Caiottk/Oficina2/(list of files, cad)

Other CAD files:
Data/ImageToStl.com_data9.ply
Data/ImageToStl.com_data12.ply
Data/ImageToStl.com_data13.ply
