Caiottk/Oficina2/PE.pdf

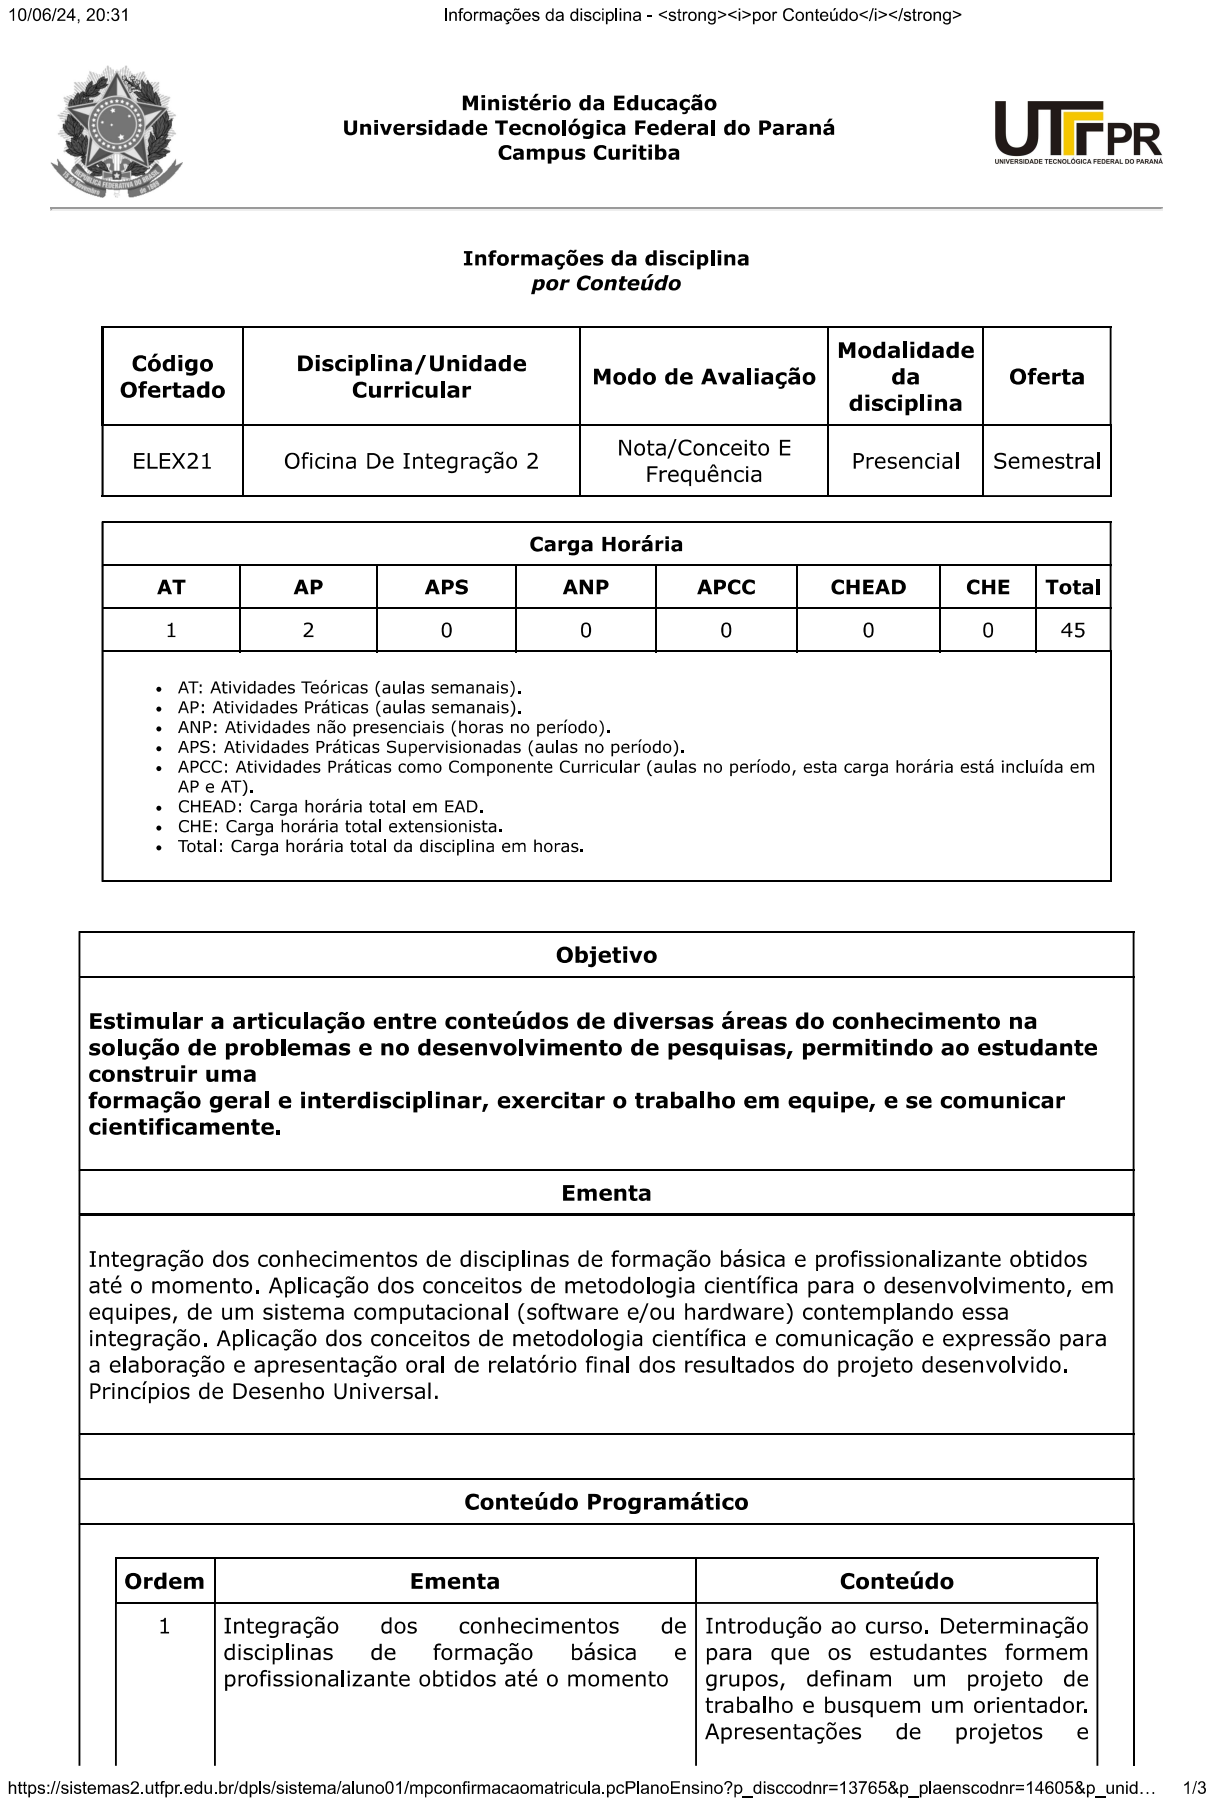
[picture p19: page 1]

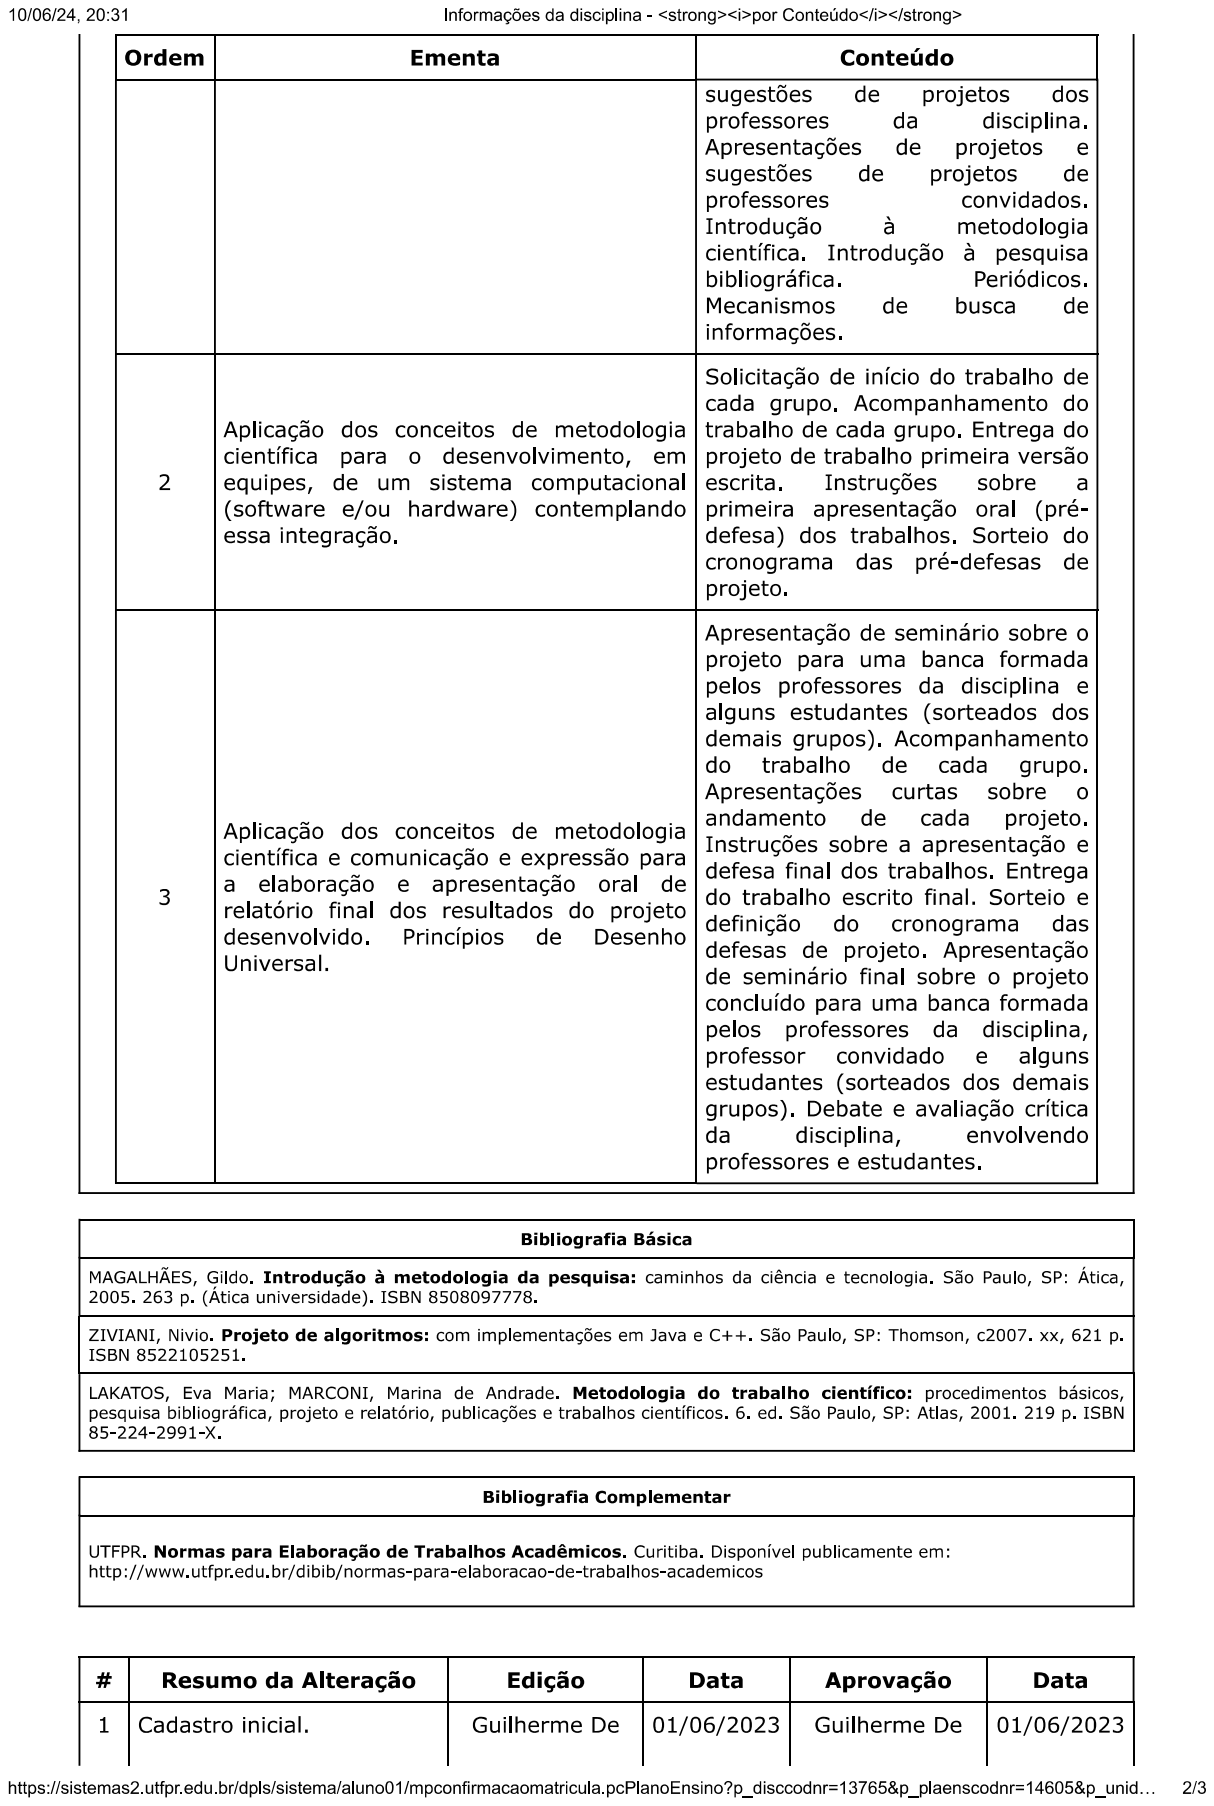
[picture p20: page 2]

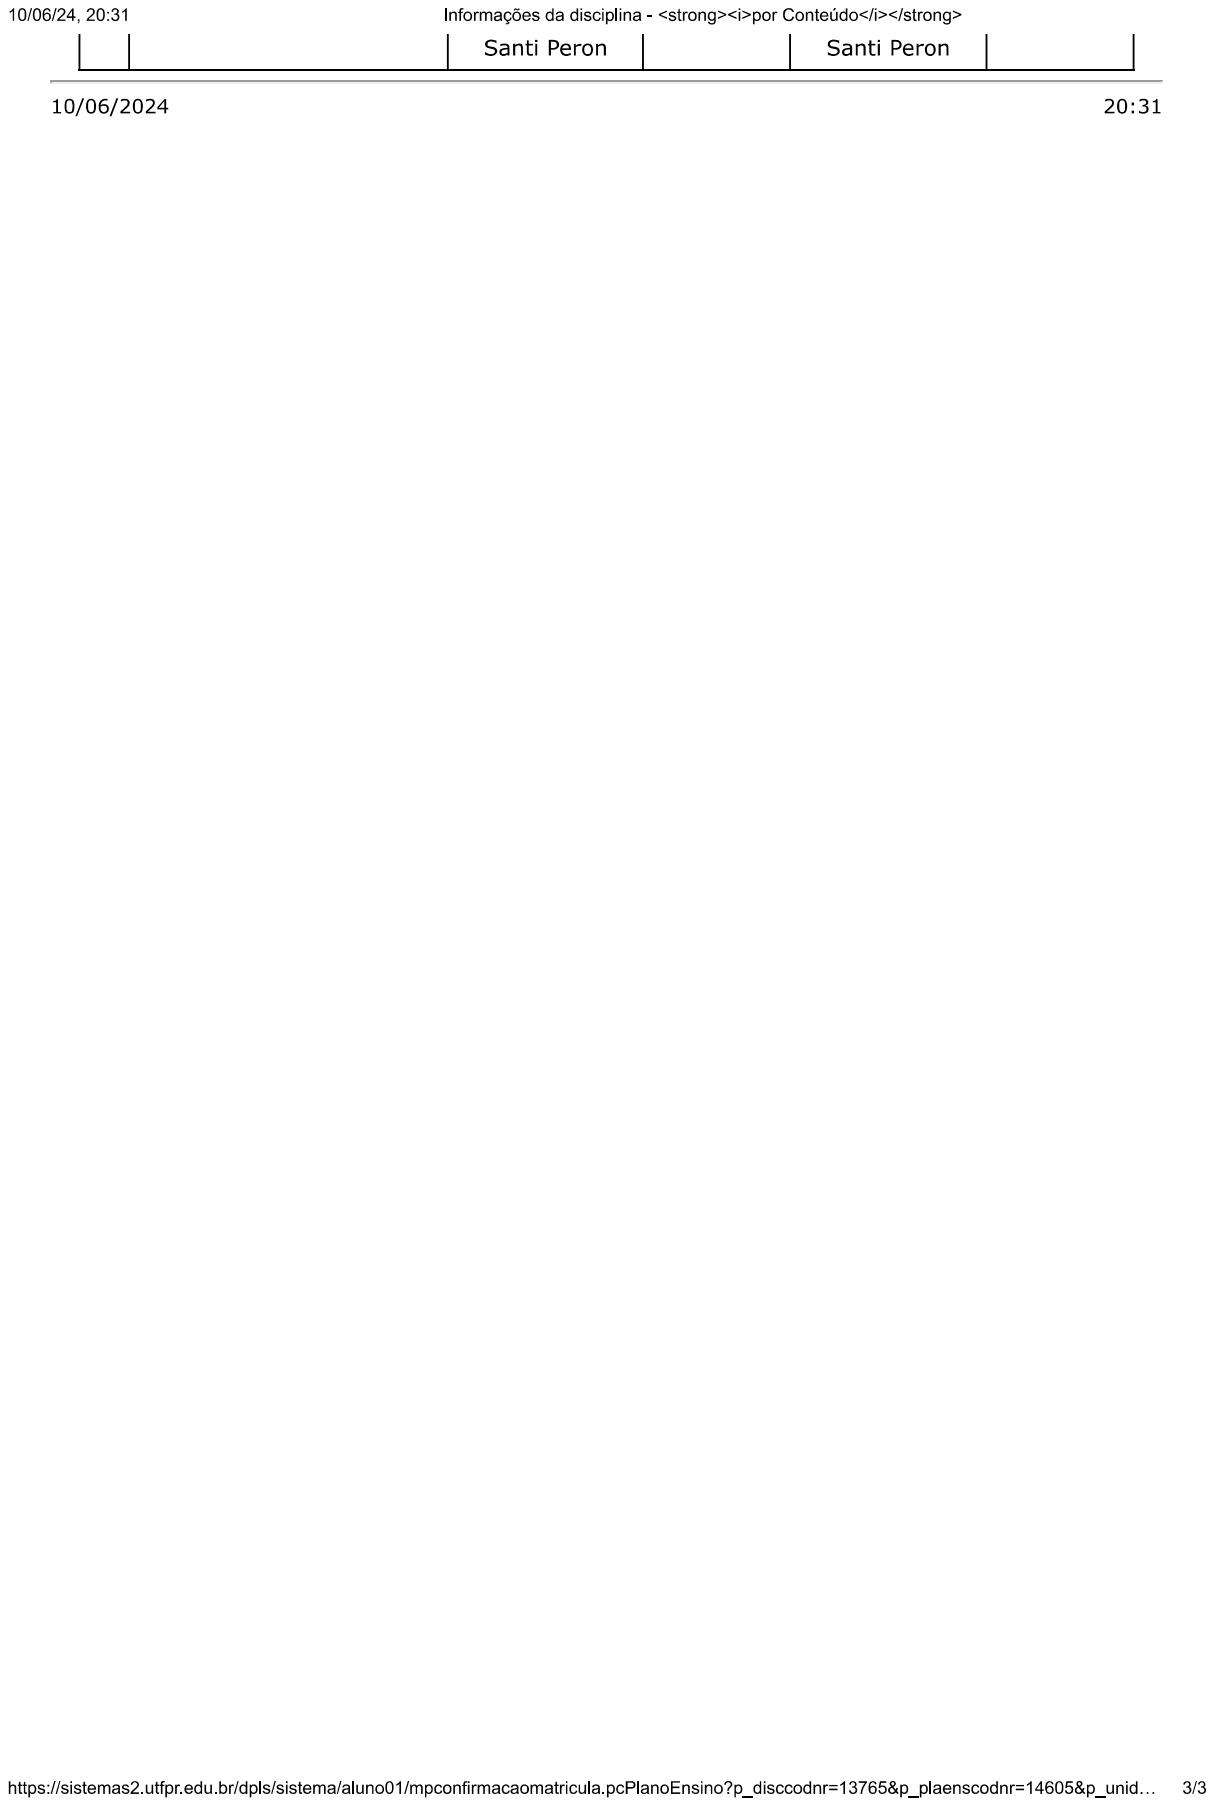
[picture p21: page 3]
